moritz157/canduino-v2/(commit log)

2020-12-04 Fixed vias near pcb-traces
    [canduino.kicad_pcb, canduino.sch]
2020-12-04 Fixed wrong button footprint
    [canduino.kicad_pcb]
2020-12-10 Added orientation markings for ICs on PCB
    [canduino.kicad_pcb]
2020-12-10 Exported gerber files
    [canduino-B.Cu.gbr, canduino-B.Mask.gbr, canduino-B.Paste.gbr, canduino-B.SilkS.gbr, canduino-Edge.Cuts.gbr, canduino-F.Cu.gbr, canduino-F.Mask.gbr, canduino-F.Paste.gbr]
