moritz157/canduino-v2/(notices)

Notices in the files:
canduino.sch:
Released under Creative Commons Attribution Share Alike 3.0 License
